EthanJFiset/Quad-USB3.0-Hub/USB 3.0 Hub/PCB Stackup - 90 Ohm Diff, 4 Layer.PNG

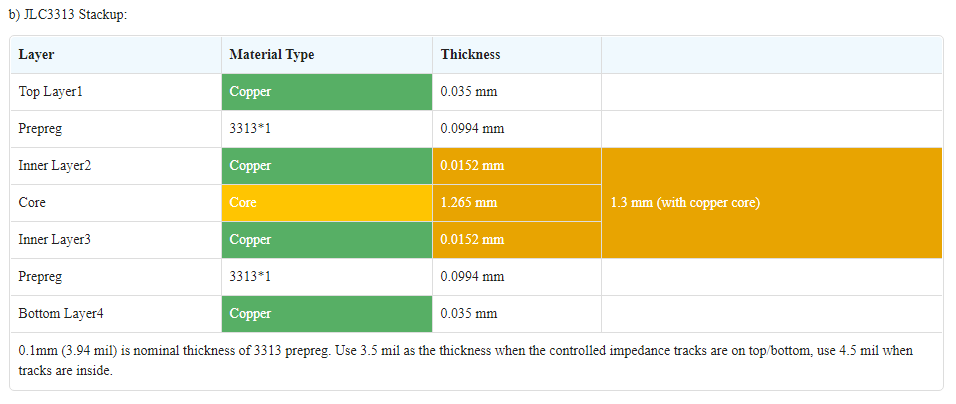
USB 3.0 Hub/PCB Stackup - 90 Ohm Diff, 4 Layer.PNG
