EthanJFiset/Quad-USB3.0-Hub/USB 3.0 Hub/Hybrid USB Hub (USB3.0).kicad_pcb

## KiCad design USB 3.0 Hub/Hybrid USB Hub (USB3.0).kicad_pcb (2024-03-23)

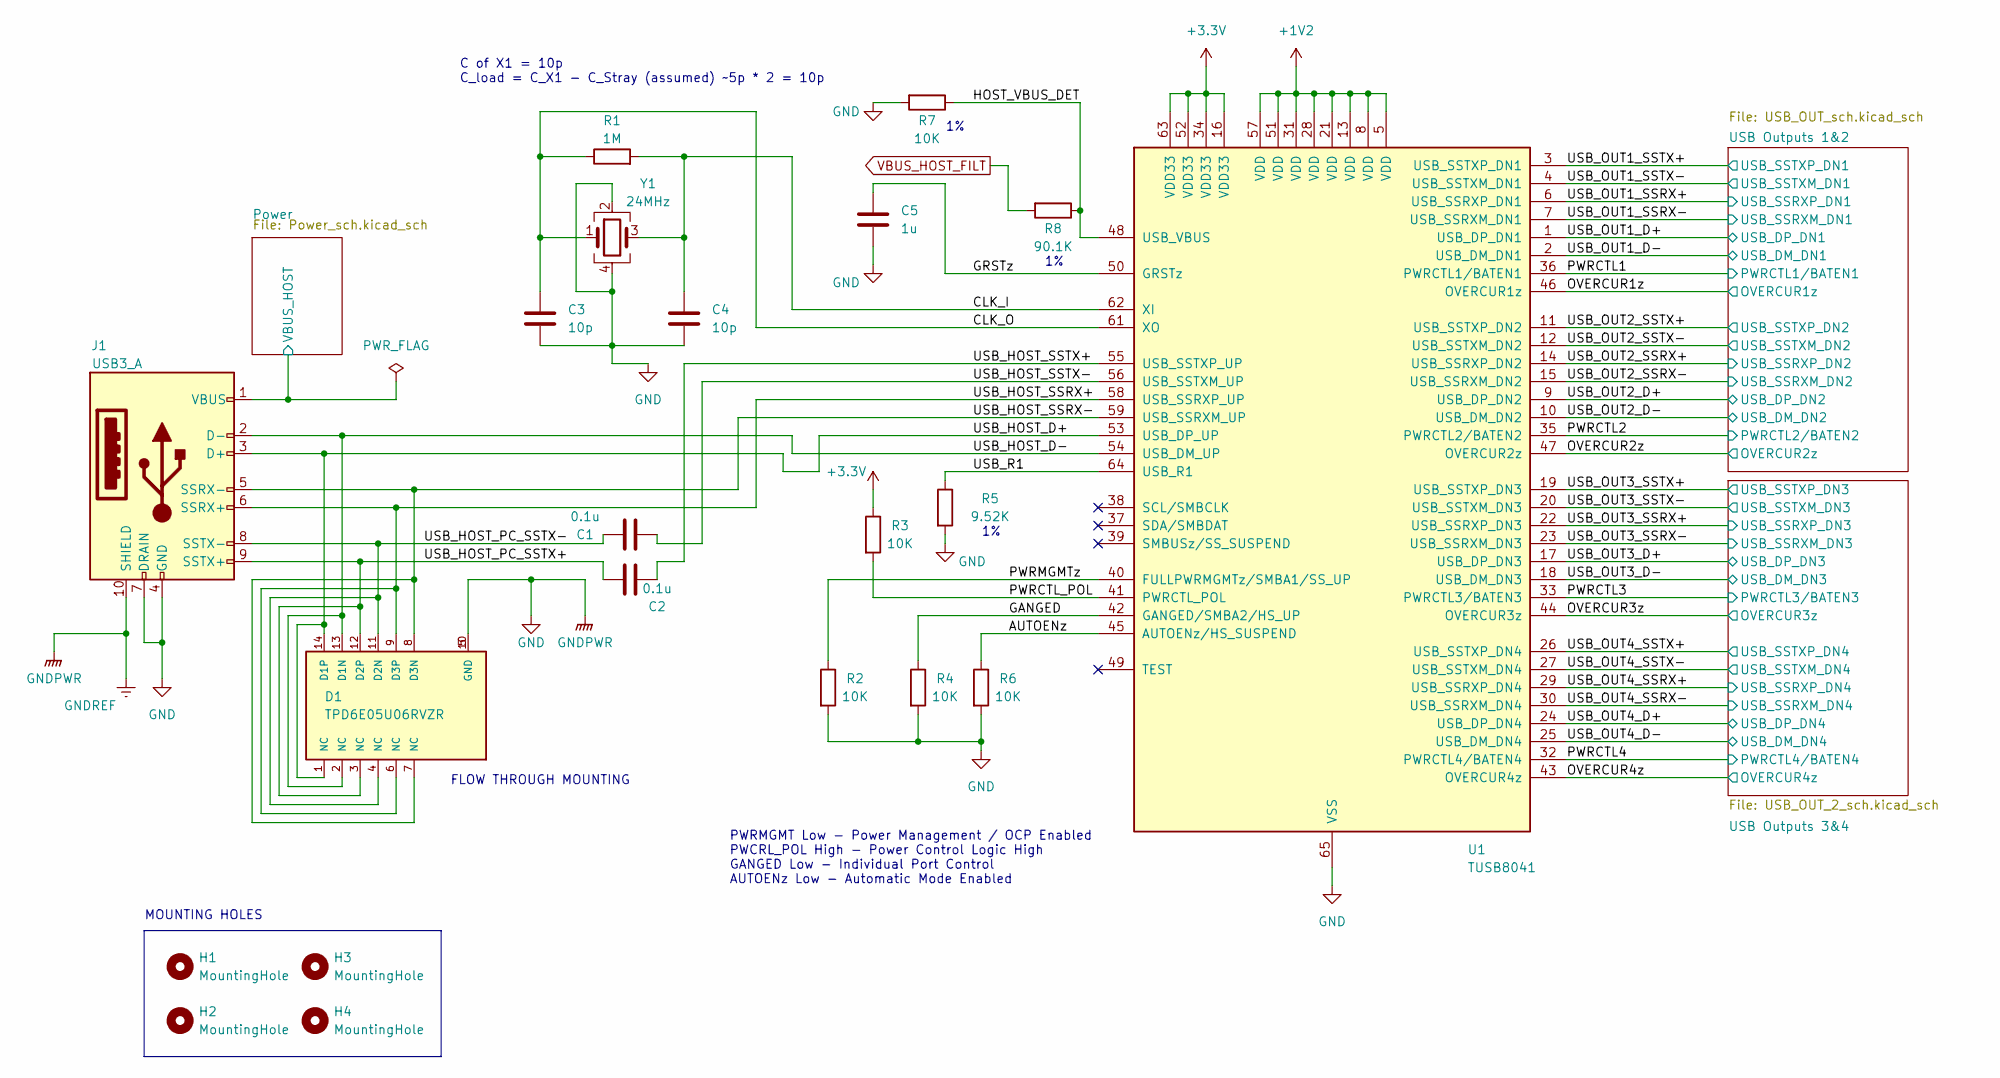
[picture p2: schematic Hybrid USB Hub (USB3.0).kicad_sch, Powered USB3.0 Quad Hub]

Parts:
C1, C2: 0.1u; C_0402_1005Metric
C3, C4: 10p; C_0402_1005Metric
C5: 1u; C_0402_1005Metric
D1: TPD6E05U06RVZR; PARTREV L
H1, H2, H3, H4: MountingHole; MountingHole_3.2mm_M3
J1: USB3_A; USB3_A_Molex_48393-001
R1: 1M; R_0402_1005Metric
R2, R3, R4, R6, R7: 10K; R_0402_1005Metric
R5: 9.52K; R_0402_1005Metric
R8: 90.1K; R_0402_1005Metric
U1: TUSB8041; QFN-64-1EP_9x9mm_P0.5mm_EP6x6mm_ThermalVias
Y1: 24MHz; Crystal_SMD_3225-4Pin_3.2x2.5mm

Connections:
+1V2: U1.5 (VDD), U1.8 (VDD), U1.13 (VDD), U1.21 (VDD), U1.28 (VDD), U1.31 (VDD), U1.51 (VDD), U1.57 (VDD); also elsewhere on the board
+3.3V: R3.1, U1.16 (VDD33), U1.34 (VDD33), U1.52 (VDD33), U1.63 (VDD33); also elsewhere on the board
/AUTOENz: R6.1, U1.45 (AUTOENz/HS_SUSPEND)
/CLK_I: C4.1, R1.2, U1.62 (XI), Y1.3
/CLK_O: C3.1, R1.1, U1.61 (XO), Y1.1
/GANGED: R4.1, U1.42 (GANGED/SMBA2/HS_UP)
/GRSTz: C5.1, U1.50 (GRSTz)
/HOST_VBUS_DET: R7.1, R8.1, U1.48 (USB_VBUS)
/OVERCUR1z: U1.46 (OVERCUR1z); also elsewhere on the board
/OVERCUR2z: U1.47 (OVERCUR2z); also elsewhere on the board
/OVERCUR3z: U1.44 (OVERCUR3z); also elsewhere on the board
/OVERCUR4z: U1.43 (OVERCUR4z); also elsewhere on the board
/PWRCTL1: U1.36 (PWRCTL1/BATEN1); also elsewhere on the board
/PWRCTL2: U1.35 (PWRCTL2/BATEN2); also elsewhere on the board
/PWRCTL3: U1.33 (PWRCTL3/BATEN3); also elsewhere on the board
/PWRCTL4: U1.32 (PWRCTL4/BATEN4); also elsewhere on the board
/PWRCTL_POL: R3.2, U1.41 (PWRCTL_POL)
/PWRMGMTz: R2.1, U1.40 (FULLPWRMGMTz/SMBA1/SS_UP)
/Power/VBUS_HOST: J1.1 (VBUS); also elsewhere on the board
/USB_HOST_D+: D1.1 (NC), D1.14 (D1P), J1.3 (D+), U1.53 (USB_DP_UP)
/USB_HOST_D-: D1.2 (NC), D1.13 (D1N), J1.2 (D-), U1.54 (USB_DM_UP)
/USB_HOST_PC_SSTX+: C2.2, D1.3 (NC), D1.12 (D2P), J1.9 (SSTX+)
/USB_HOST_PC_SSTX-: C1.2, D1.4 (NC), D1.11 (D2N), J1.8 (SSTX-)
/USB_HOST_SSRX+: D1.6 (NC), D1.9 (D3P), J1.6 (SSRX+), U1.58 (USB_SSRXP_UP)
/USB_HOST_SSRX-: D1.7 (NC), D1.8 (D3N), J1.5 (SSRX-), U1.59 (USB_SSRXM_UP)
/USB_HOST_SSTX+: C2.1, U1.55 (USB_SSTXP_UP)
/USB_HOST_SSTX-: C1.1, U1.56 (USB_SSTXM_UP)
/USB_OUT1_D+: U1.1 (USB_DP_DN1); also elsewhere on the board
/USB_OUT1_D-: U1.2 (USB_DM_DN1); also elsewhere on the board
/USB_OUT1_SSRX+: U1.6 (USB_SSRXP_DN1); also elsewhere on the board
/USB_OUT1_SSRX-: U1.7 (USB_SSRXM_DN1); also elsewhere on the board
/USB_OUT1_SSTX+: U1.3 (USB_SSTXP_DN1); also elsewhere on the board
/USB_OUT1_SSTX-: U1.4 (USB_SSTXM_DN1); also elsewhere on the board
/USB_OUT2_D+: U1.9 (USB_DP_DN2); also elsewhere on the board
/USB_OUT2_D-: U1.10 (USB_DM_DN2); also elsewhere on the board
/USB_OUT2_SSRX+: U1.14 (USB_SSRXP_DN2); also elsewhere on the board
/USB_OUT2_SSRX-: U1.15 (USB_SSRXM_DN2); also elsewhere on the board
/USB_OUT2_SSTX+: U1.11 (USB_SSTXP_DN2); also elsewhere on the board
/USB_OUT2_SSTX-: U1.12 (USB_SSTXM_DN2); also elsewhere on the board
/USB_OUT3_D+: U1.17 (USB_DP_DN3); also elsewhere on the board
/USB_OUT3_D-: U1.18 (USB_DM_DN3); also elsewhere on the board
/USB_OUT3_SSRX+: U1.22 (USB_SSRXP_DN3); also elsewhere on the board
/USB_OUT3_SSRX-: U1.23 (USB_SSRXM_DN3); also elsewhere on the board
/USB_OUT3_SSTX+: U1.19 (USB_SSTXP_DN3); also elsewhere on the board
/USB_OUT3_SSTX-: U1.20 (USB_SSTXM_DN3); also elsewhere on the board
/USB_OUT4_D+: U1.24 (USB_DP_DN4); also elsewhere on the board
/USB_OUT4_D-: U1.25 (USB_DM_DN4); also elsewhere on the board
/USB_OUT4_SSRX+: U1.29 (USB_SSRXP_DN4); also elsewhere on the board
/USB_OUT4_SSRX-: U1.30 (USB_SSRXM_DN4); also elsewhere on the board
/USB_OUT4_SSTX+: U1.26 (USB_SSTXP_DN4); also elsewhere on the board
/USB_OUT4_SSTX-: U1.27 (USB_SSTXM_DN4); also elsewhere on the board
/USB_R1: R5.1, U1.64 (USB_R1)
GND: C3.2, C4.2, C5.2, D1.5 (GND), D1.10 (GND), J1.4 (GND), J1.7 (DRAIN), J1.10 (SHIELD), R2.2, R4.2, R5.2, R6.2, R7.2, U1.65 (VSS), Y1.2, Y1.4; also elsewhere on the board
VBUS_HOST_FILT: R8.2

Notes on the sheet:
MOUNTING HOLES
FLOW THROUGH MOUNTING
C of X1 = 10p C_load = C_X1 - C_Stray (assumed) ~5p * 2 = 10p
PWRMGMT Low - Power Management / OCP Enabled PWCRL_POL High - Power Control Logic High GANGED Low - Individual Port Control AUTOENz Low - Automatic Mode Enabled

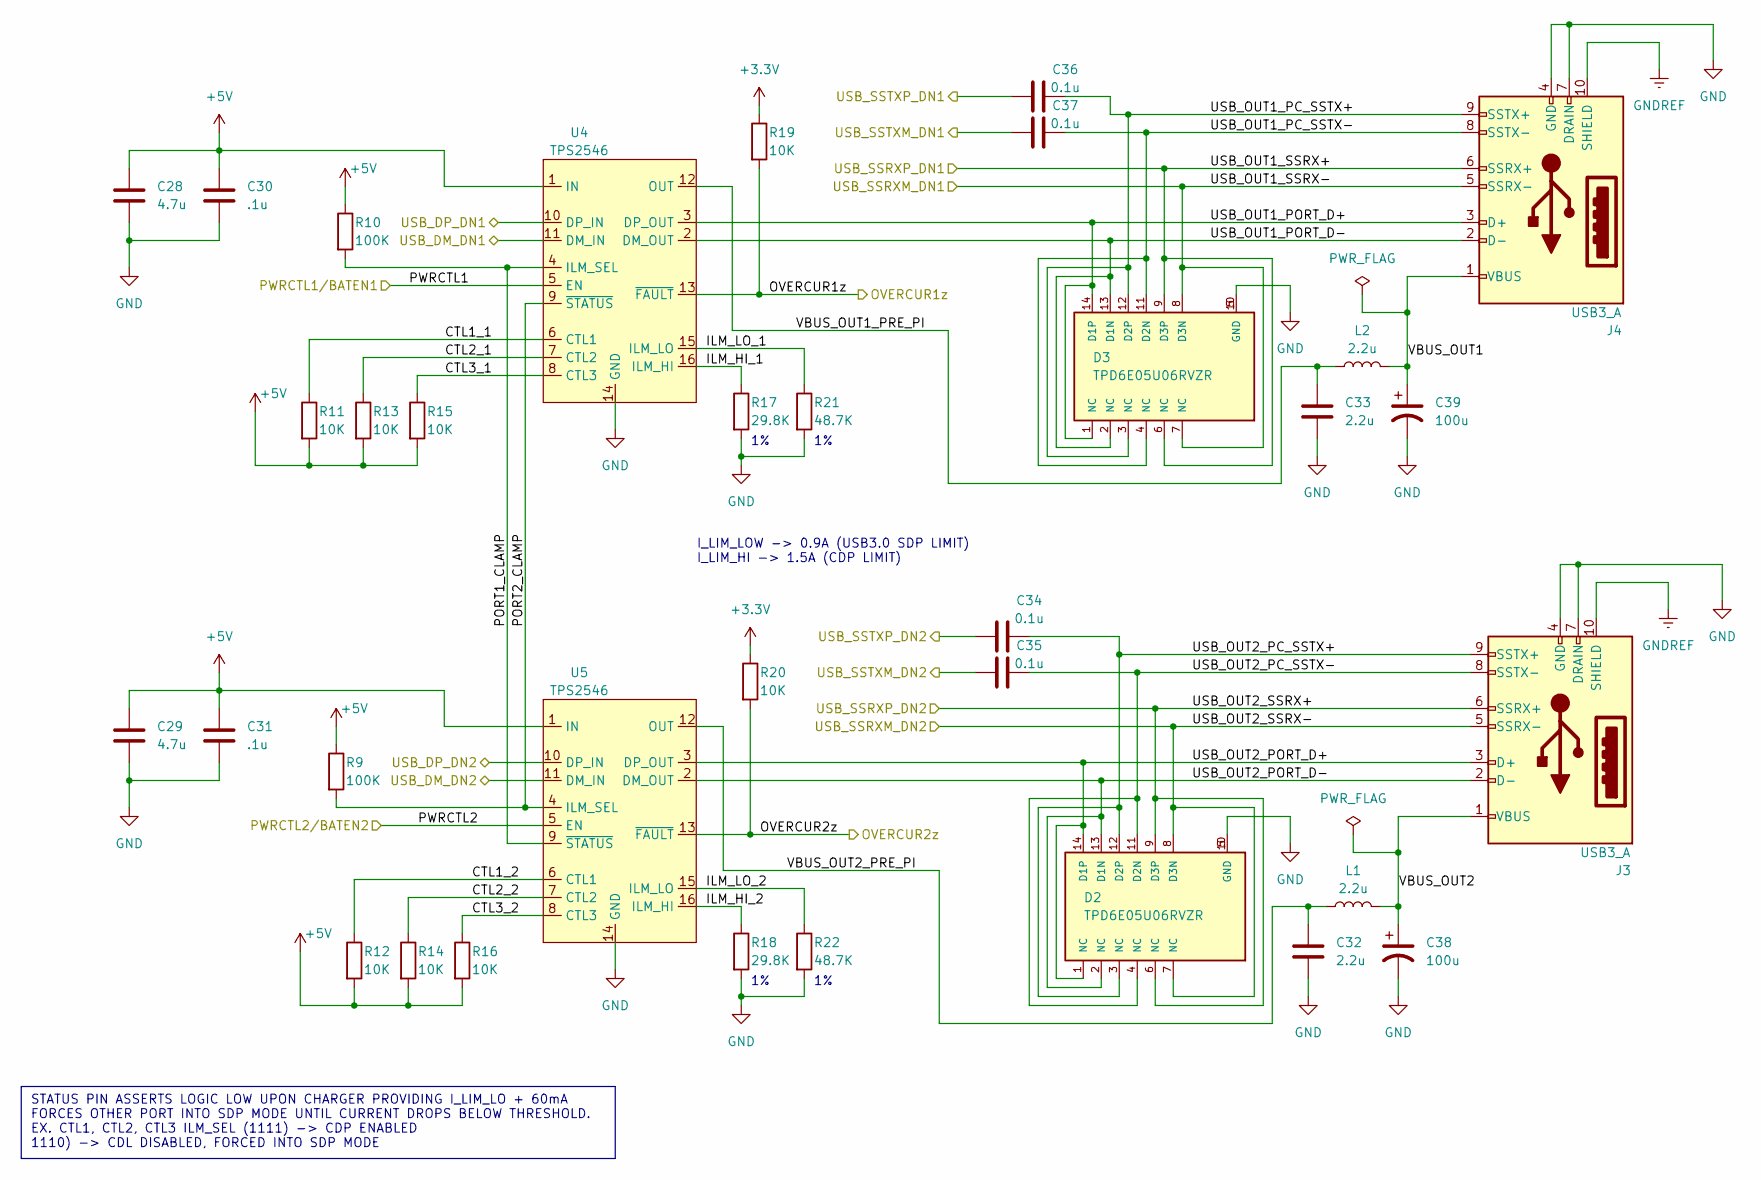
[picture p3: schematic USB_OUT_sch.kicad_sch, Powered USB3.0 Quad Hub]

Parts:
C28, C29: 4.7u; C_0402_1005Metric
C30, C31: .1u; C_0402_1005Metric
C32, C33: 2.2u; C_0402_1005Metric
C34, C35, C36, C37: 0.1u; C_0402_1005Metric
C38, C39: 100u; CP_Radial_D5.0mm_P2.50mm
D2, D3: TPD6E05U06RVZR; PARTREV L
J3, J4: USB3_A; USB3_A_Molex_48393-001
L1, L2: 2.2u; L_0402_1005Metric
R9, R10: 100K; R_0402_1005Metric
R11, R12, R13, R14, R15, R16, R19, R20: 10K; R_0402_1005Metric
R17, R18: 29.8K; R_0402_1005Metric
R21, R22: 48.7K; R_0402_1005Metric
U4, U5: TPS2546; TPS2546RTER

Connections:
+3.3V: R19.1, R20.1; also elsewhere on the board
+5V: C28.1, C29.1, C30.1, C31.1, R9.1, R10.1, R11.2, R12.2, R13.2, R14.2, R15.2, R16.2, U4.1 (IN), U5.1 (IN); also elsewhere on the board
/OVERCUR1z: R19.2, U4.13 (~FAULT); also elsewhere on the board
/OVERCUR2z: R20.2, U5.13 (~FAULT); also elsewhere on the board
/PWRCTL1: U4.5 (EN); also elsewhere on the board
/PWRCTL2: U5.5 (EN); also elsewhere on the board
/USB Outputs 1&2/CTL1_1: R11.1, U4.6 (CTL1)
/USB Outputs 1&2/CTL1_2: R12.1, U5.6 (CTL1)
/USB Outputs 1&2/CTL2_1: R13.1, U4.7 (CTL2)
/USB Outputs 1&2/CTL2_2: R14.1, U5.7 (CTL2)
/USB Outputs 1&2/CTL3_1: R15.1, U4.8 (CTL3)
/USB Outputs 1&2/CTL3_2: R16.1, U5.8 (CTL3)
/USB Outputs 1&2/ILM_HI_1: R17.1, U4.16 (ILM_HI)
/USB Outputs 1&2/ILM_HI_2: R18.1, U5.16 (ILM_HI)
/USB Outputs 1&2/ILM_LO_1: R21.1, U4.15 (ILM_LO)
/USB Outputs 1&2/ILM_LO_2: R22.1, U5.15 (ILM_LO)
/USB Outputs 1&2/PORT1_CLAMP: R10.2, U4.4 (ILM_SEL), U5.9 (~STATUS)
/USB Outputs 1&2/PORT2_CLAMP: R9.2, U4.9 (~STATUS), U5.4 (ILM_SEL)
/USB Outputs 1&2/USB_OUT1_PC_SSTX+: C36.2, D3.3 (NC), D3.12 (D2P), J4.9 (SSTX+)
/USB Outputs 1&2/USB_OUT1_PC_SSTX-: C37.2, D3.4 (NC), D3.11 (D2N), J4.8 (SSTX-)
/USB Outputs 1&2/USB_OUT1_PORT_D+: D3.1 (NC), D3.14 (D1P), J4.3 (D+), U4.3 (DP_OUT)
/USB Outputs 1&2/USB_OUT1_PORT_D-: D3.2 (NC), D3.13 (D1N), J4.2 (D-), U4.2 (DM_OUT)
/USB Outputs 1&2/USB_OUT2_PC_SSTX+: C34.2, D2.3 (NC), D2.12 (D2P), J3.9 (SSTX+)
/USB Outputs 1&2/USB_OUT2_PC_SSTX-: C35.2, D2.4 (NC), D2.11 (D2N), J3.8 (SSTX-)
/USB Outputs 1&2/USB_OUT2_PORT_D+: D2.1 (NC), D2.14 (D1P), J3.3 (D+), U5.3 (DP_OUT)
/USB Outputs 1&2/USB_OUT2_PORT_D-: D2.2 (NC), D2.13 (D1N), J3.2 (D-), U5.2 (DM_OUT)
/USB Outputs 1&2/VBUS_OUT1: C39.1, J4.1 (VBUS), L2.2
/USB Outputs 1&2/VBUS_OUT1_PRE_PI: C33.1, L2.1, U4.12 (OUT)
/USB Outputs 1&2/VBUS_OUT2: C38.1, J3.1 (VBUS), L1.2
/USB Outputs 1&2/VBUS_OUT2_PRE_PI: C32.1, L1.1, U5.12 (OUT)
/USB_OUT1_D+: U4.10 (DP_IN); also elsewhere on the board
/USB_OUT1_D-: U4.11 (DM_IN); also elsewhere on the board
/USB_OUT1_SSRX+: D3.6 (NC), D3.9 (D3P), J4.6 (SSRX+); also elsewhere on the board
/USB_OUT1_SSRX-: D3.7 (NC), D3.8 (D3N), J4.5 (SSRX-); also elsewhere on the board
/USB_OUT1_SSTX+: C36.1; also elsewhere on the board
/USB_OUT1_SSTX-: C37.1; also elsewhere on the board
/USB_OUT2_D+: U5.10 (DP_IN); also elsewhere on the board
/USB_OUT2_D-: U5.11 (DM_IN); also elsewhere on the board
/USB_OUT2_SSRX+: D2.6 (NC), D2.9 (D3P), J3.6 (SSRX+); also elsewhere on the board
/USB_OUT2_SSRX-: D2.7 (NC), D2.8 (D3N), J3.5 (SSRX-); also elsewhere on the board
/USB_OUT2_SSTX+: C34.1; also elsewhere on the board
/USB_OUT2_SSTX-: C35.1; also elsewhere on the board
GND: C28.2, C29.2, C30.2, C31.2, C32.2, C33.2, C38.2, C39.2, D2.5 (GND), D2.10 (GND), D3.5 (GND), D3.10 (GND), J3.4 (GND), J3.7 (DRAIN), J3.10 (SHIELD), J4.4 (GND), J4.7 (DRAIN), J4.10 (SHIELD), R17.2, R18.2, R21.2, R22.2, U4.14 (GND), U5.14 (GND); also elsewhere on the board

Notes on the sheet:
STATUS PIN ASSERTS LOGIC LOW UPON CHARGER PROVIDING I_LIM_LO + 60mA FORCES OTHER PORT INTO SDP MODE UNTIL CURRENT DROPS BELOW THRESHOLD. EX. CTL1, CTL2, CTL3 ILM_SEL (1111) -> CDP ENABLED 1110) -> CDL DISABLED, FORCED INTO SDP MODE
I_LIM_LOW -> 0.9A (USB3.0 SDP LIMIT) I_LIM_HI -> 1.5A (CDP LIMIT)

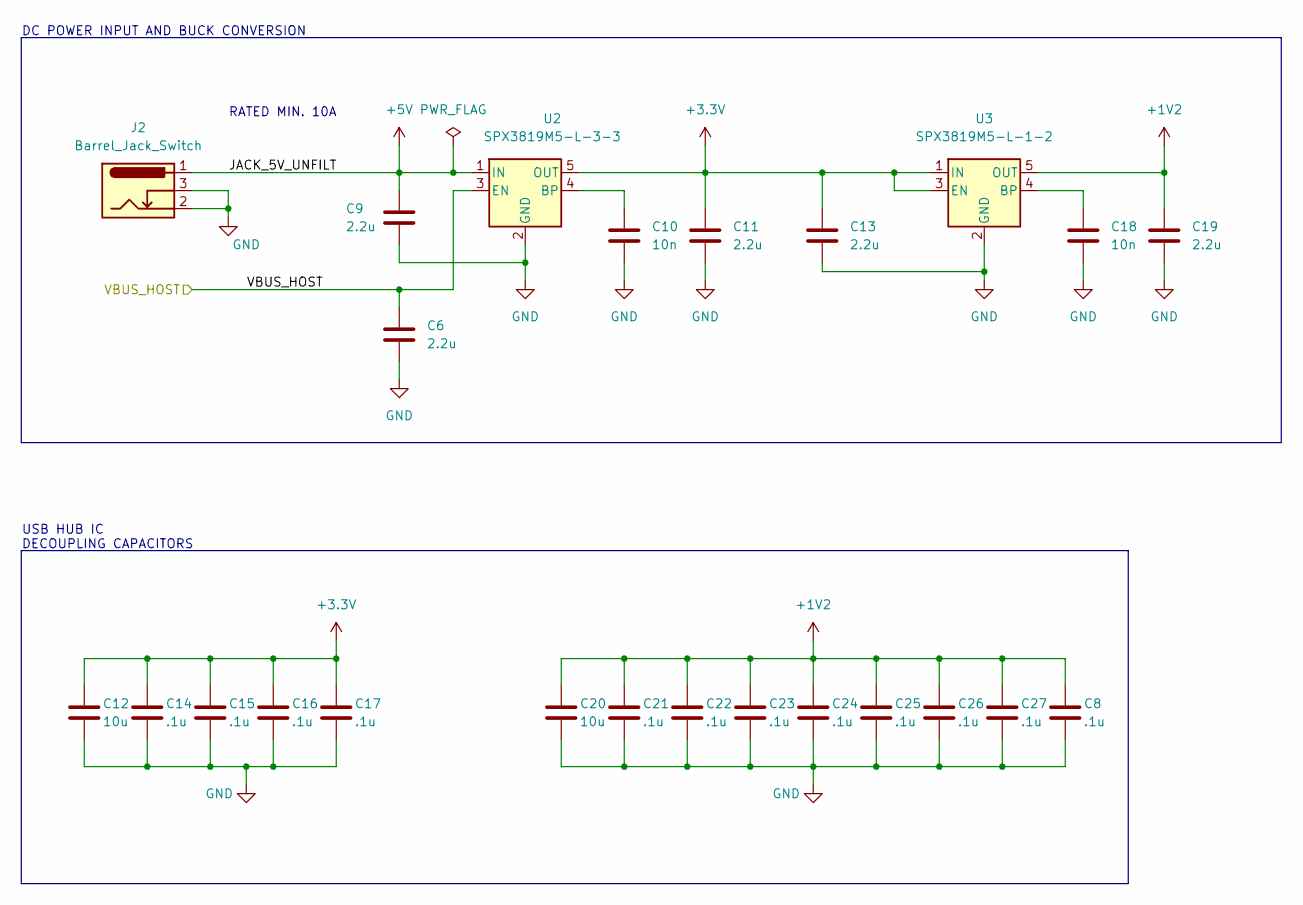
[picture p4: schematic Power_sch.kicad_sch, Powered USB3.0 Quad Hub]

Parts:
C6, C9, C11, C13, C19: 2.2u; C_0402_1005Metric
C8, C14, C15, C16, C17, C21, C22, C23, C24, C25, C26, C27: .1u; C_0402_1005Metric
C10, C18: 10n; C_0402_1005Metric
C12, C20: 10u; C_0603_1608Metric
J2: Barrel_Jack_Switch; BarrelJack_CUI_PJ-063AH_Horizontal
U2: SPX3819M5-L-3-3; SOT-23-5
U3: SPX3819M5-L-1-2; SOT-23-5

Connections:
+1V2: C8.1, C19.1, C20.1, C21.1, C22.1, C23.1, C24.1, C25.1, C26.1, C27.1, U3.5 (OUT); also elsewhere on the board
+3.3V: C11.1, C12.1, C13.1, C14.1, C15.1, C16.1, C17.1, U2.5 (OUT), U3.1 (IN), U3.3 (EN); also elsewhere on the board
+5V: C9.1, J2.1, U2.1 (IN); also elsewhere on the board
/Power/VBUS_HOST: C6.1, U2.3 (EN); also elsewhere on the board
GND: C6.2, C8.2, C9.2, C10.2, C11.2, C12.2, C13.2, C14.2, C15.2, C16.2, C17.2, C18.2, C19.2, C20.2, C21.2, C22.2, C23.2, C24.2, C25.2, C26.2, C27.2, J2.2, J2.3, U2.2 (GND), U3.2 (GND); also elsewhere on the board
unnamed: C10.1, U2.4 (BP)
unnamed: C18.1, U3.4 (BP)

Notes on the sheet:
DC POWER INPUT AND BUCK CONVERSION
USB HUB IC DECOUPLING CAPACITORS
RATED MIN. 10A

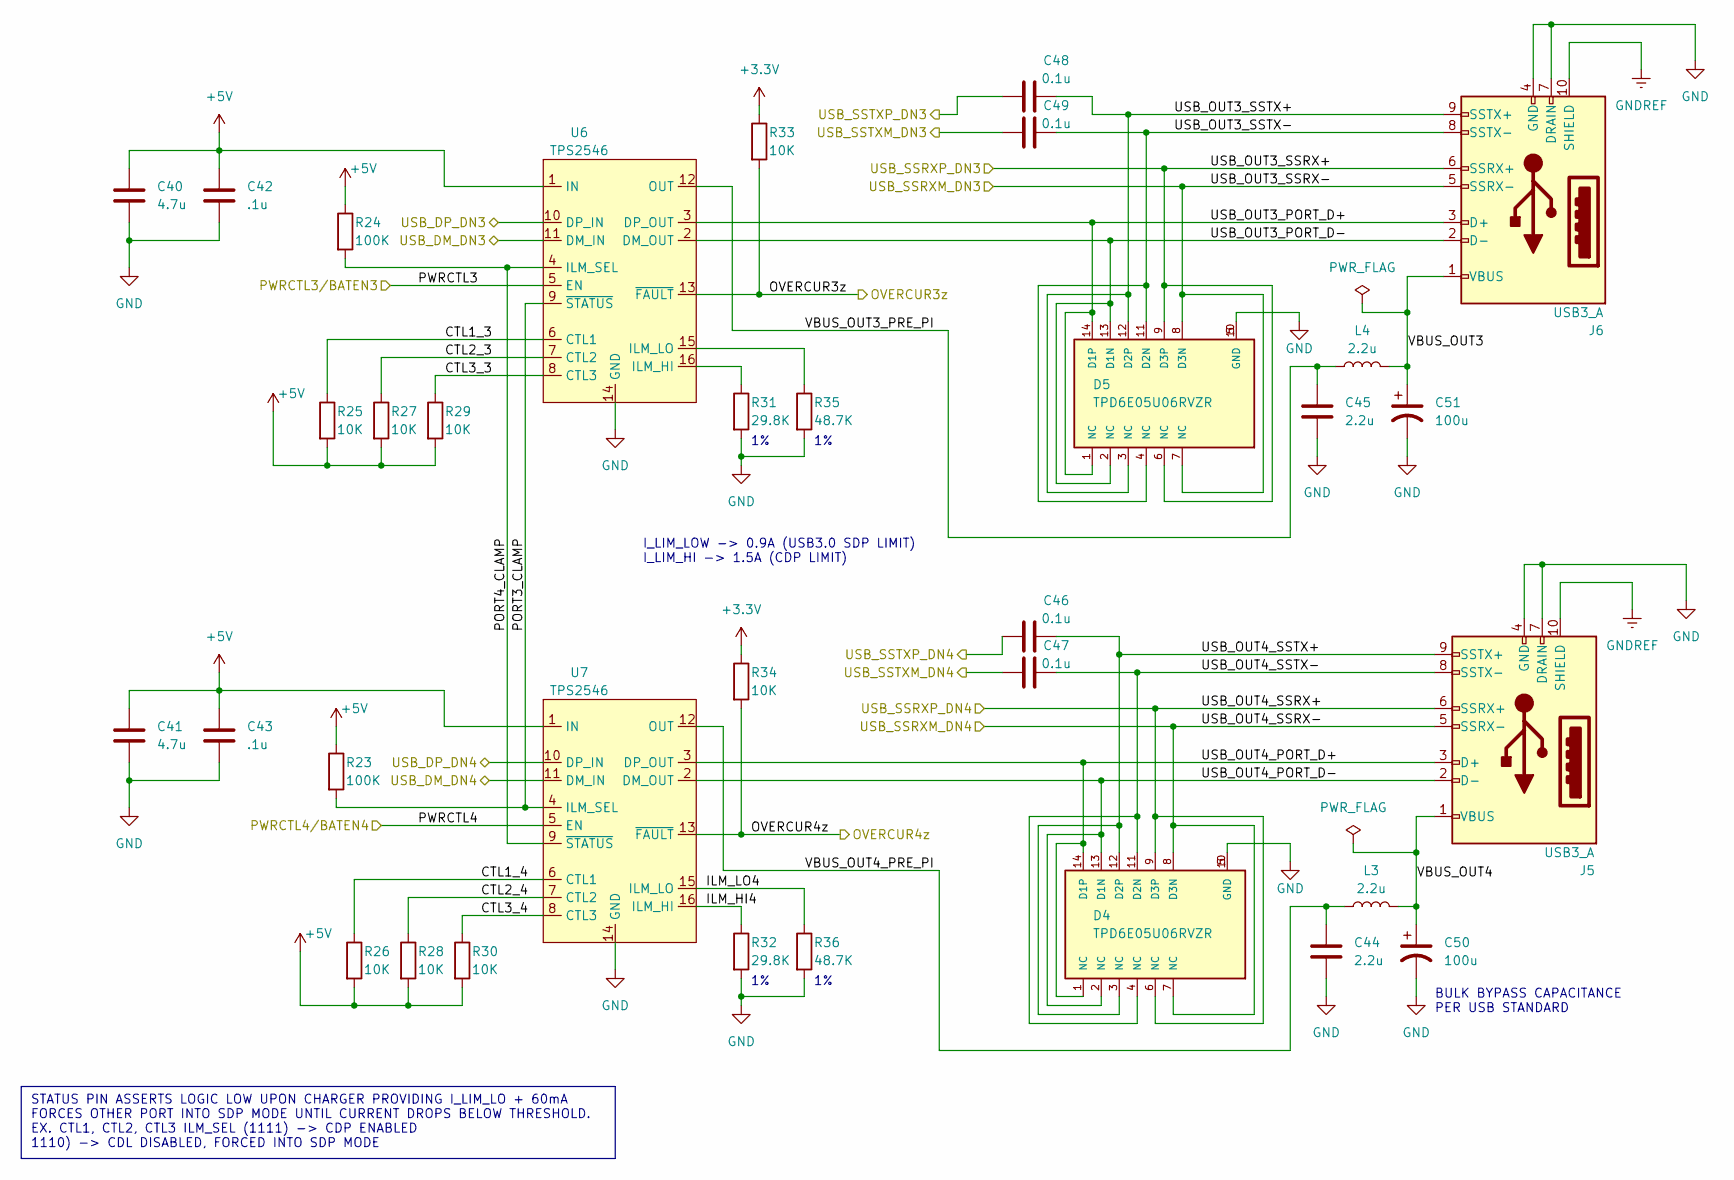
[picture p5: schematic USB_OUT_2_sch.kicad_sch, Powered USB3.0 Quad Hub]

Parts:
C40, C41: 4.7u; C_0402_1005Metric
C42, C43: .1u; C_0402_1005Metric
C44, C45: 2.2u; C_0402_1005Metric
C46, C47, C48, C49: 0.1u; C_0402_1005Metric
C50, C51: 100u; CP_Radial_D5.0mm_P2.50mm
D4, D5: TPD6E05U06RVZR; PARTREV L
J5, J6: USB3_A; USB3_A_Molex_48393-001
L3, L4: 2.2u; L_0402_1005Metric
R23, R24: 100K; R_0402_1005Metric
R25, R26, R27, R28, R29, R30, R33, R34: 10K; R_0402_1005Metric
R31, R32: 29.8K; R_0402_1005Metric
R35, R36: 48.7K; R_0402_1005Metric
U6, U7: TPS2546; TPS2546RTER

Connections:
+3.3V: R33.1, R34.1; also elsewhere on the board
+5V: C40.1, C41.1, C42.1, C43.1, R23.1, R24.1, R25.2, R26.2, R27.2, R28.2, R29.2, R30.2, U6.1 (IN), U7.1 (IN); also elsewhere on the board
/OVERCUR3z: R33.2, U6.13 (~FAULT); also elsewhere on the board
/OVERCUR4z: R34.2, U7.13 (~FAULT); also elsewhere on the board
/PWRCTL3: U6.5 (EN); also elsewhere on the board
/PWRCTL4: U7.5 (EN); also elsewhere on the board
/USB Outputs 3&4/CTL1_3: R25.1, U6.6 (CTL1)
/USB Outputs 3&4/CTL1_4: R26.1, U7.6 (CTL1)
/USB Outputs 3&4/CTL2_3: R27.1, U6.7 (CTL2)
/USB Outputs 3&4/CTL2_4: R28.1, U7.7 (CTL2)
/USB Outputs 3&4/CTL3_3: R29.1, U6.8 (CTL3)
/USB Outputs 3&4/CTL3_4: R30.1, U7.8 (CTL3)
/USB Outputs 3&4/ILM_HI4: R32.1, U7.16 (ILM_HI)
/USB Outputs 3&4/ILM_LO4: R36.1, U7.15 (ILM_LO)
/USB Outputs 3&4/PORT3_CLAMP: R23.2, U6.9 (~STATUS), U7.4 (ILM_SEL)
/USB Outputs 3&4/PORT4_CLAMP: R24.2, U6.4 (ILM_SEL), U7.9 (~STATUS)
/USB Outputs 3&4/USB_OUT3_PORT_D+: D5.1 (NC), D5.14 (D1P), J6.3 (D+), U6.3 (DP_OUT)
/USB Outputs 3&4/USB_OUT3_PORT_D-: D5.2 (NC), D5.13 (D1N), J6.2 (D-), U6.2 (DM_OUT)
/USB Outputs 3&4/USB_OUT3_SSTX+: C48.2, D5.3 (NC), D5.12 (D2P), J6.9 (SSTX+)
/USB Outputs 3&4/USB_OUT3_SSTX-: C49.2, D5.4 (NC), D5.11 (D2N), J6.8 (SSTX-)
/USB Outputs 3&4/USB_OUT4_PORT_D+: D4.1 (NC), D4.14 (D1P), J5.3 (D+), U7.3 (DP_OUT)
/USB Outputs 3&4/USB_OUT4_PORT_D-: D4.2 (NC), D4.13 (D1N), J5.2 (D-), U7.2 (DM_OUT)
/USB Outputs 3&4/USB_OUT4_SSTX+: C46.2, D4.3 (NC), D4.12 (D2P), J5.9 (SSTX+)
/USB Outputs 3&4/USB_OUT4_SSTX-: C47.2, D4.4 (NC), D4.11 (D2N), J5.8 (SSTX-)
/USB Outputs 3&4/VBUS_OUT3: C51.1, J6.1 (VBUS), L4.2
/USB Outputs 3&4/VBUS_OUT3_PRE_PI: C45.1, L4.1, U6.12 (OUT)
/USB Outputs 3&4/VBUS_OUT4: C50.1, J5.1 (VBUS), L3.2
/USB Outputs 3&4/VBUS_OUT4_PRE_PI: C44.1, L3.1, U7.12 (OUT)
/USB_OUT3_D+: U6.10 (DP_IN); also elsewhere on the board
/USB_OUT3_D-: U6.11 (DM_IN); also elsewhere on the board
/USB_OUT3_SSRX+: D5.6 (NC), D5.9 (D3P), J6.6 (SSRX+); also elsewhere on the board
/USB_OUT3_SSRX-: D5.7 (NC), D5.8 (D3N), J6.5 (SSRX-); also elsewhere on the board
/USB_OUT3_SSTX+: C48.1; also elsewhere on the board
/USB_OUT3_SSTX-: C49.1; also elsewhere on the board
/USB_OUT4_D+: U7.10 (DP_IN); also elsewhere on the board
/USB_OUT4_D-: U7.11 (DM_IN); also elsewhere on the board
/USB_OUT4_SSRX+: D4.6 (NC), D4.9 (D3P), J5.6 (SSRX+); also elsewhere on the board
/USB_OUT4_SSRX-: D4.7 (NC), D4.8 (D3N), J5.5 (SSRX-); also elsewhere on the board
/USB_OUT4_SSTX+: C46.1; also elsewhere on the board
/USB_OUT4_SSTX-: C47.1; also elsewhere on the board
GND: C40.2, C41.2, C42.2, C43.2, C44.2, C45.2, C50.2, C51.2, D4.5 (GND), D4.10 (GND), D5.5 (GND), D5.10 (GND), J5.4 (GND), J5.7 (DRAIN), J5.10 (SHIELD), J6.4 (GND), J6.7 (DRAIN), J6.10 (SHIELD), R31.2, R32.2, R35.2, R36.2, U6.14 (GND), U7.14 (GND); also elsewhere on the board
unnamed: R31.1, U6.16 (ILM_HI)
unnamed: R35.1, U6.15 (ILM_LO)

Notes on the sheet:
STATUS PIN ASSERTS LOGIC LOW UPON CHARGER PROVIDING I_LIM_LO + 60mA FORCES OTHER PORT INTO SDP MODE UNTIL CURRENT DROPS BELOW THRESHOLD. EX. CTL1, CTL2, CTL3 ILM_SEL (1111) -> CDP ENABLED 1110) -> CDL DISABLED, FORCED INTO SDP MODE
I_LIM_LOW -> 0.9A (USB3.0 SDP LIMIT) I_LIM_HI -> 1.5A (CDP LIMIT)
BULK BYPASS CAPACITANCE PER USB STANDARD

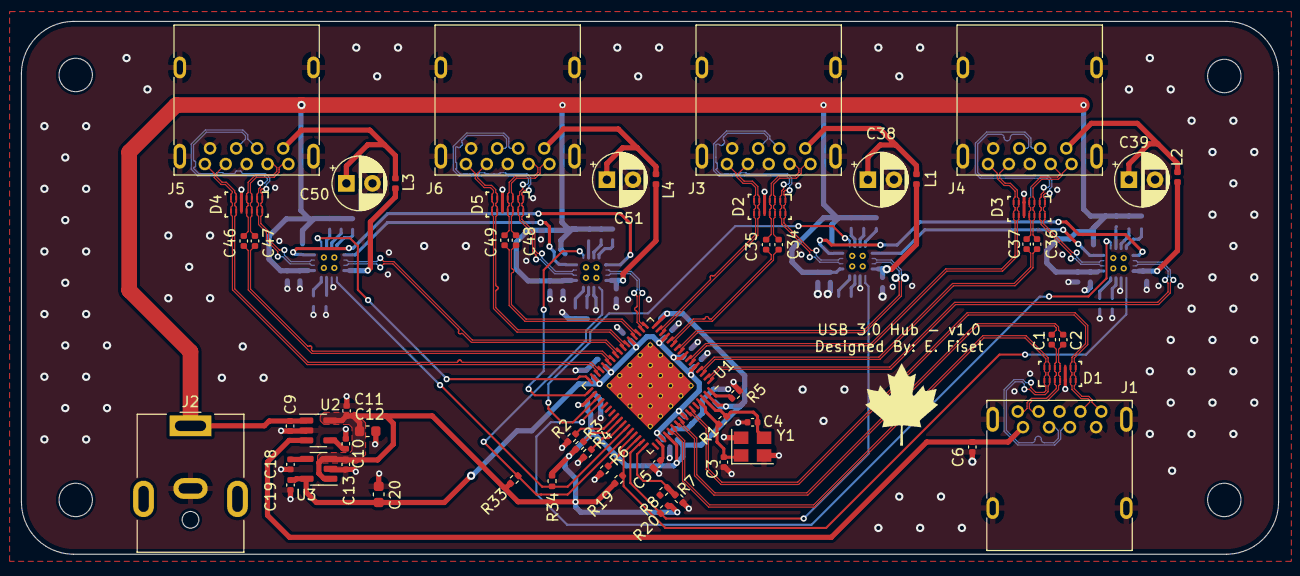
[picture p6: board Hybrid USB Hub (USB3.0).kicad_pcb from above]

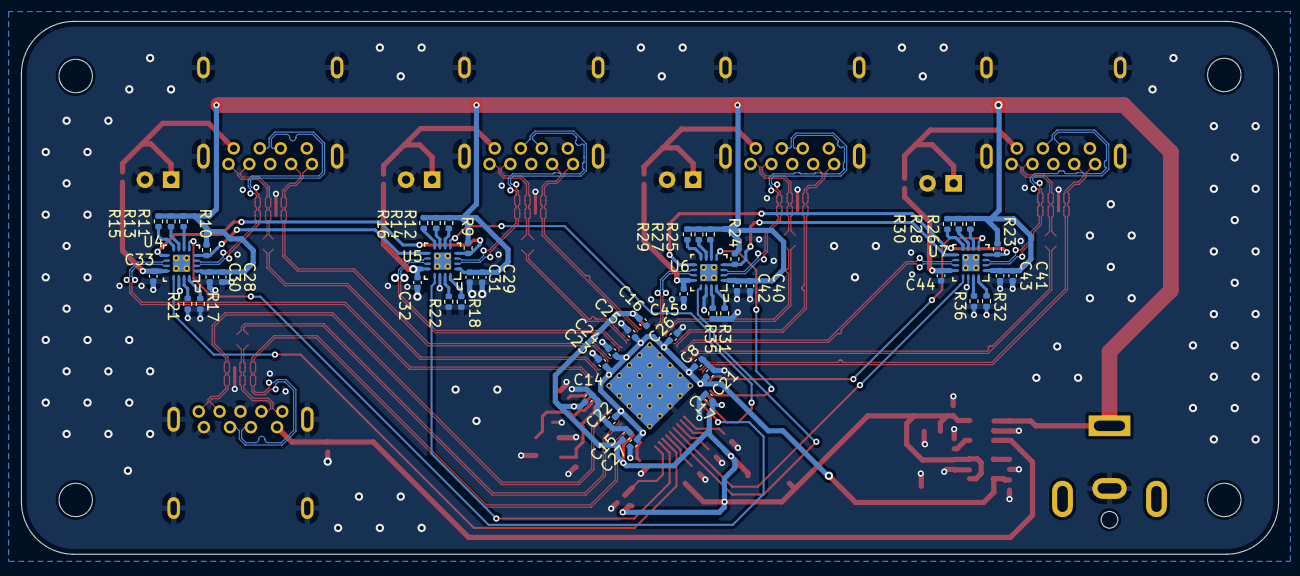
[picture p7: board Hybrid USB Hub (USB3.0).kicad_pcb from below]

Board: 4 copper layers, 120.4 x 51.0 mm, 113 parts (52 on the bottom side), 104 nets.
